LabAutoSig/Lab_Auto_Camera_Detection/Python_installation/requirements_display_detection.txt

numpy == 1.24.2
opencv-python == 4.6.0.66
opencv-contrib-python == 4.6.0.66
imutils == 0.5.4
uuid == 1.30
Ultralytics == 8.1.8
torch == 2.7.0
torchvision == 0.22.0
pandas == 2.0.1
dill == 0.3.8
openpyxl == 3.1.5
