LabAutoSig/Lab_Auto_Camera_Detection/display_detection/Enhanced_imgs/enhanced_img.png

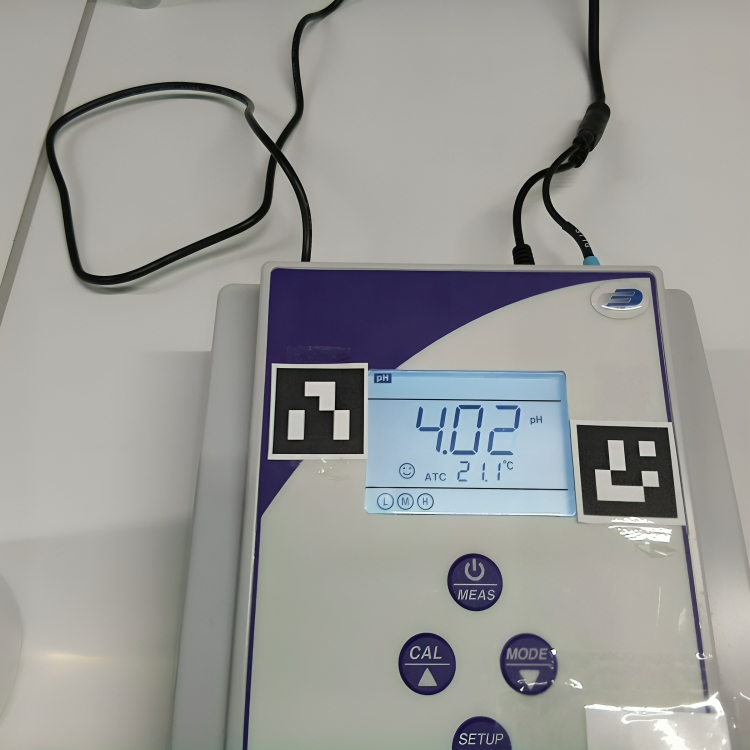
display_detection/Enhanced_imgs/enhanced_img.png
