LabAutoSig/Lab_Auto_Camera_Detection/display_detection/Processed_imgs/cropped_img.jpg

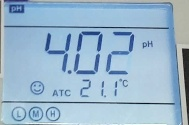
display_detection/Processed_imgs/cropped_img.jpg
