LabAutoSig/Lab_Auto_Camera_Detection/runs/detect/predict2/image0.jpg

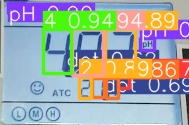
runs/detect/predict2/image0.jpg
