LabAutoSig/Lab_Auto_Camera_Detection/test.stp

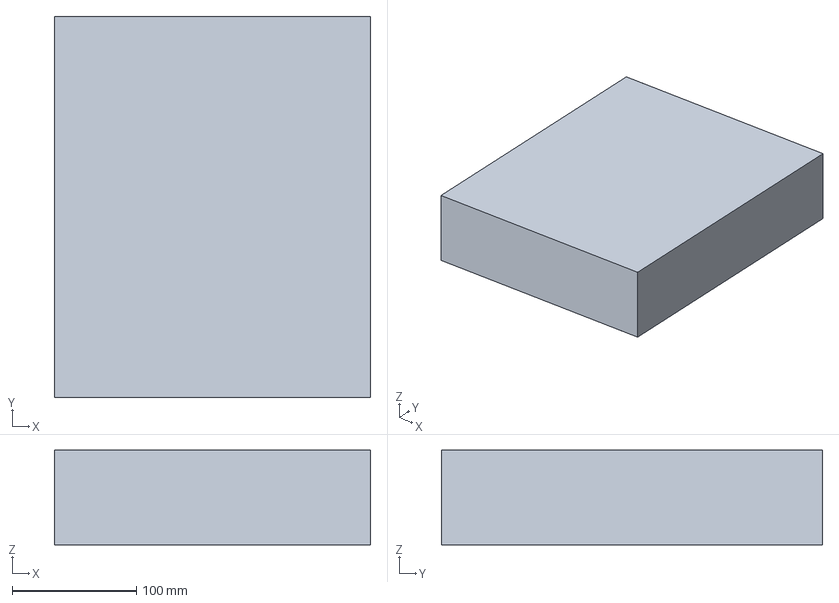
[picture p6: CAD file, 2025-05-23]
test.stp
254.1 x 306.6 x 76.3 mm
