LabAutoSig/Lab_Auto_Camera_Detection/three_D_reconstruction/HORST_world/test.stp

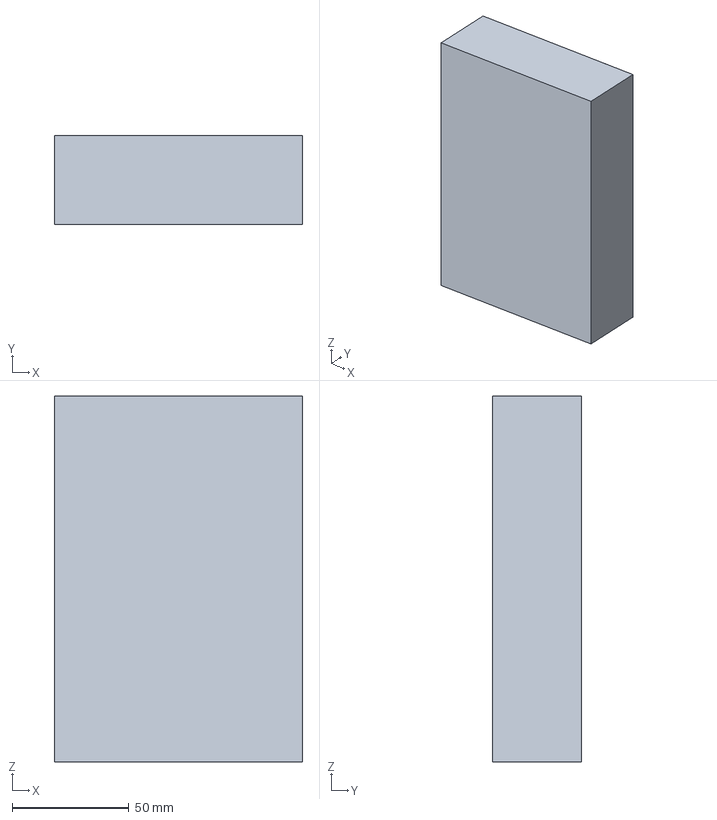
[picture p7: CAD file, 2025-04-29]
three_D_reconstruction/HORST_world/test.stp
106.3 x 38.1 x 156.6 mm
