LabAutoSig/Lab_Auto_Camera_Detection/Python_installation/requirements_3D_reconstruction.txt

numpy == 1.24.2
opencv-python == 4.6.0.66
opencv-contrib-python == 4.6.0.66
pandas == 2.0.1
scipy == 1.10.1
PySide2 == 5.15.2.1
wheel == 0.41.2
