LabAutoSig/Lab_Auto_Camera_Detection/three_D_reconstruction/input/coordinates_camera_pose1_camera_pose2.csv

Coordinates:
[  70.04308441 -448.60216797  203.53008667]
[-184.02915833 -142.02699554  184.3933374 ]
U
[[-61.08571121 -97.43288696 127.27883545]
 [-87.21105835 -92.19095886 122.80880371]
 [-83.19274399 -68.49335754 129.09041992]
 [-57.42921612 -73.02100647 130.8185083 ]]
Distances:
254.0722427368164
306.5751724243164
76.25125122070312
