LabAutoSig/Lab_Auto_Camera_Detection/autoit-v3/install/Examples/COM/Worksheet.xls

This is cell A1
 | This is cell B2
