LabAutoSig/Lab_Auto_Camera_Detection/autoit-v3/install/Examples/Helpfile/Extras/_Excel1.xls

Sheet: Tabelle1
1 | 10 | 100 | 1000 | 10000 | This is a long Story | Col1 | Col2 | Col3
2 | 20 | 200 | 2000 | 20000 | This is a Story that's even longer | f | 1 | 10.10 | 2012-10-01
3 | 30 | 300 | 3000 | 30000 |  | e | 2 | 9.70 | 2012-10-02
4 | 40 | 400 | 4000 | 40000 |  | d | 3 | 2.15 | 2012-10-03
5 | 50 | 500 | 5000 | 50000 |  | c | 4 | 3.00 | 2012-10-04
6 | 60 | 600 | 6000 | 60000 |  | b | 5 | 7.50 | 2012-10-05
7 | 70 | 700 | 7000 | 70000 |  | a | 6 | 26.08 | 2013-10-15
8 | 80 | 800 | 8000 | 80000 |  |  |  |  | 2013-10-16
9 | 90 | 900 | 9000 | 90000 |  |  |  |  | 2013-10-17
10 | 100 | 1000 | 10000 | 100000 |  |  |  |  | 2013-11-18
11 | 110 | 1100 | 11000 | 110000 |  |  |  |  | 2013-11-19
12 | 120 | 1200 | 12000 | 120000 |  |  |  |  | 2013-12-20
13 | 130 | 1300 | 13000 | 130000 |  |  |  |  | 2013-12-21
14 | 140 | 1400 | 14000 | 140000 |  |  |  |  | 2014-10-22
15 | 150 | 1500 | 15000 | 150000 |  |  |  |  | 2014-10-23
16 | 160 | 1600 | 16000 | 160000 |  |  |  |  | 2014-10-24
17 | 170 | 1700 | 17000 | 170000 |  |  |  |  | 2014-10-25
18 | 180 | 1800 | 18000 | 180000
19 | 190 | 1900 | 19000 | 190000
20 | 200 | 2000 | 20000 | 200000
21 | 210 | 2100 | 21000 | 210000
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
