LabAutoSig/Lab_Auto_Camera_Detection/autoit-v3/install/Examples/Helpfile/Extras/_Excel2.xls

Sheet: _ExcelWriteSheetFromArray
 |  |  | 20000
 |  |  | 30000
 |  |  | 40000
 |  |  | 50000
 |  |  | 60000
 |  |  | 70000
 |  |  | 80000
 |  |  | 90000
 | 20 | 200 | 100000
 | 30 | 300 | 110000
 | 40 | 400 | 120000
 | 50 | 500 | 130000
 | 60 | 600 | 140000
 | 70 | 700 | 150000
 | 80 | 800 | 160000
 | 90 | 900 | 170000
 | 100 | 1000 | 180000
 | 110 | 1100 | 190000
 | 120 | 1200 | 200000
 | 130 | 1300 | 210000
 | 140 | 1400 | 220000
 | 150 | 1500 | 230000
 | 160 | 1600 | 240000
 | 170 | 1700 | 250000
 | 180 | 1800 | 260000
 | 190 | 1900 | 270000
 | 200 | 2000 | 280000
 | 210 | 2100 | 290000
 | 220 | 2200 | 300000
 | 230 | 2300 | 310000
 | 240 | 2400 | 320000
 | 250 | 2500 | 330000
 | 260 | 2600 | 340000
 | 270 | 2700 | 350000
 | 280 | 2800 | 360000
 | 290 | 2900 | 370000
 | 300 | 3000 | 380000
 | 310 | 3100 | 390000
 | 320 | 3200 | 400000
 | 330 | 3300 | 410000
 | 340 | 3400 | 420000
 | 350 | 3500 | 430000
 | 360 | 3600 | 440000
 | 370 | 3700 | 450000
 | 380 | 3800 | 460000
 | 390 | 3900 | 470000
 | 400 | 4000 | 480000
 | 410 | 4100 | 490000
 | 420 | 4200 | 500000
 | 430 | 4300 | 510000
 | 440 | 4400 | 520000
 | 450 | 4500 | 530000
 | 460 | 4600 | 540000
 | 470 | 4700 | 550000
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
