LabAutoSig/Lab_Auto_Camera_Detection/autoit-v3/install/Examples/Helpfile/Extras/_Excel3.xls

Sheet: _ExcelWriteSheetFromArray
*-------------* | *-------------* | *-------------* | *-------------* | *-------------* | *-------------* | *-------------* | *-------------* | *-------------* | *-------------* | *-------------* | *-------------* | *-------------* | *-------------* | *-------------* | *-------------* | *-------------* | *-------------* | *-------------* | *-------------* | *-------------* | *-------------* | *-------------* | *-------------* | *-------------* | *-------------* | *-------------* | *-------------* | *-------------* | *-------------* | *-------------* | *-------------* | *-------------* | *-------------* | *-------------* | *-------------* | *-------------* | *-------------* | *-------------* | *-------------* | *-------------*
*-------------* | *-------------* | *-------------* | *-------------* | *-------------* | *-------------* | *-------------* | *-------------* | *-------------* | *-------------* | *-------------* | *-------------* | *-------------* | *-------------* | *-------------* | *-------------* | *-------------* | *-------------* | *-------------* | *-------------* | *-------------* | *-------------* | *-------------* | *-------------* | *-------------* | *-------------* | *-------------* | *-------------* | *-------------* | *-------------* | *-------------* | *-------------* | *-------------* | *-------------* | *-------------* | *-------------* | *-------------* | *-------------* | *-------------* | *-------------* | *-------------*
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

Sheet: Tabelle1
1 | 10 | 100 | 1000 | 10000
2 | 20 | 200 | 2000 | 20000
3 | 30 | 300 | 3000 | 30000
4 | 40 | 400 | 4000 | 40000
5 | 50 | 500 | 5000 | 50000
6 | 60 | 600 | 6000 | 60000
7 | 70 | 700 | 7000 | 70000
8 | 80 | 800 | 8000 | 80000
9 | 90 | 900 | 9000 | 90000
10 | 100 | 1000 | 10000 | 100000
11 | 110 | 1100 | 11000 | 110000
12 | 120 | 1200 | 12000 | 120000
13 | 130 | 1300 | 13000 | 130000
14 | 140 | 1400 | 14000 | 140000
15 | 150 | 1500 | 15000 | 150000
16 | 160 | 1600 | 16000 | 160000
17 | 170 | 1700 | 17000 | 170000
18 | 180 | 1800 | 18000 | 180000
19 | 190 | 1900 | 19000 | 190000
20 | 200 | 2000 | 20000 | 200000
21 | 210 | 2100 | 21000 | 210000
22 | 220 | 2200 | 22000 | 220000
23 | 230 | 2300 | 23000 | 230000
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
