LabAutoSig/Lab_Auto_Camera_Detection/autoit-v3/install/Examples/Helpfile/Extras/_Excel4.xls

Sheet: Tabelle1
Sheet1
A1 | B1 | C1 | D1
A2 | B2 | C2 | D2
A3 | B3 | C3 | D3
A4 | B4 | C4 | D4

Sheet: Tabelle2
Sheet2
A1 | B1 | C1 | D1
A2 | B2 | C2 | D2
A3 | B3 | C3 | D3
A4 | B4 | C4 | D4

Sheet: Tabelle3
Sheet3
A1 | B1 | C1 | D1
A2 | B2 | C2 | D2
A3 | B3 | C3 | D3
A4 | B4 | C4 | D4
