LabAutoSig/Lab_Auto_Camera_Detection/three_D_reconstruction/input/1.jpg

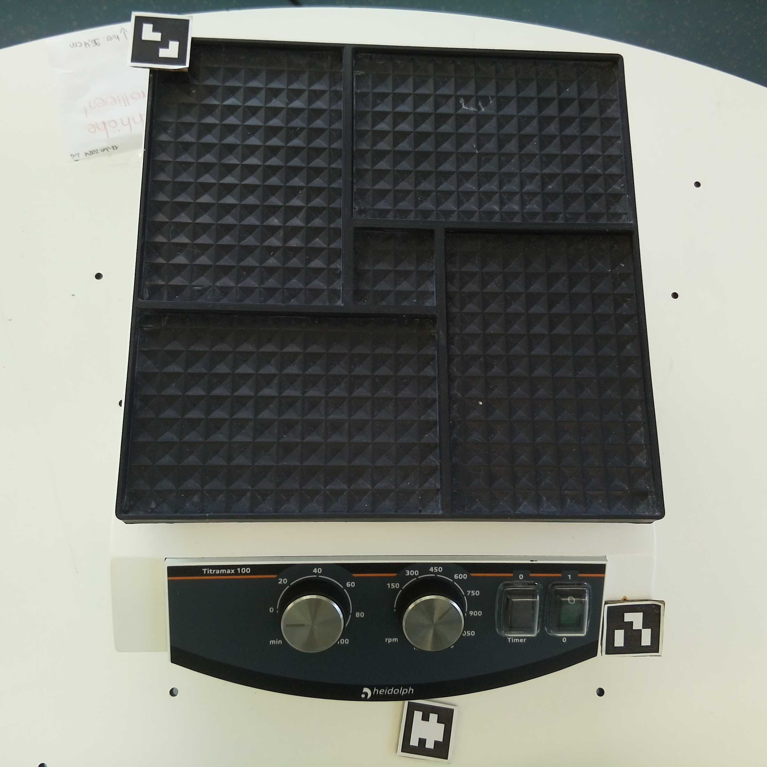
three_D_reconstruction/input/1.jpg
