LabAutoSig/Lab_Auto_Camera_Detection/three_D_reconstruction/input/07_05_devices/5.jpg

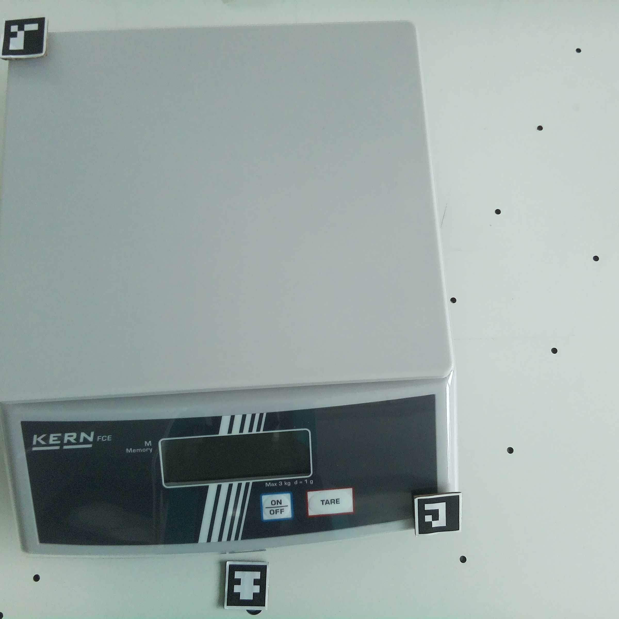
three_D_reconstruction/input/07_05_devices/5.jpg
