LabAutoSig/Lab_Auto_Camera_Detection/Python_installation/requirements_camera_calibration.txt

numpy == 1.26.2
opencv-contrib-python == 4.8.1.78
uuid == 1.30
