LabAutoSig/Lab_Auto_Camera_Detection/display_detection/Input_img/Test_imgs/Test_04_11_24/cs series scale/rawimg89.jpg

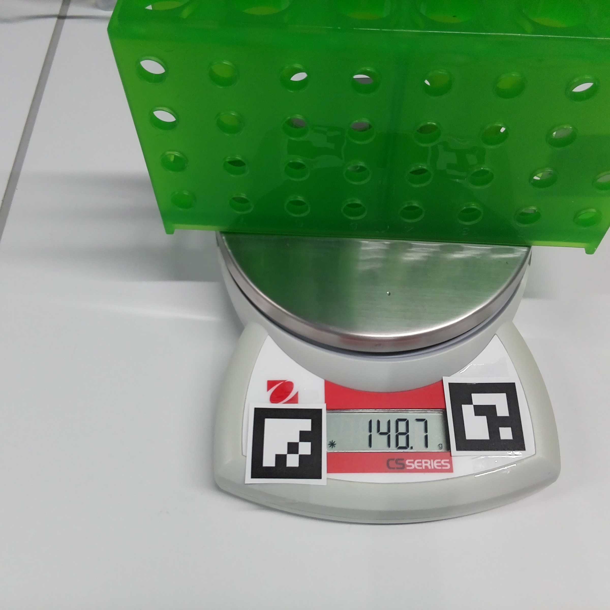
display_detection/Input_img/Test_imgs/Test_04_11_24/cs series scale/rawimg89.jpg
