LabAutoSig/Lab_Auto_Camera_Detection/display_detection/Input_img/Test_imgs/Variation_lighting/rawimg52.jpg

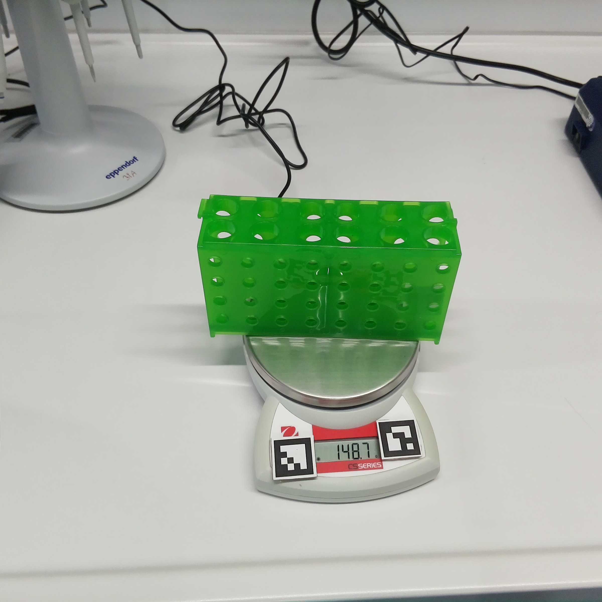
display_detection/Input_img/Test_imgs/Variation_lighting/rawimg52.jpg
