LabAutoSig/Lab_Auto_Camera_Detection/display_detection/Saved_Images/ result_6d22893f-a6d4-4648-952b-289575cfeb5b.jpg

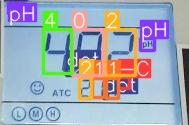
display_detection/Saved_Images/ result_6d22893f-a6d4-4648-952b-289575cfeb5b.jpg
