LabAutoSig/Lab_Auto_Camera_Detection/three_D_reconstruction/input/Control_Book_measurement/1.jpg

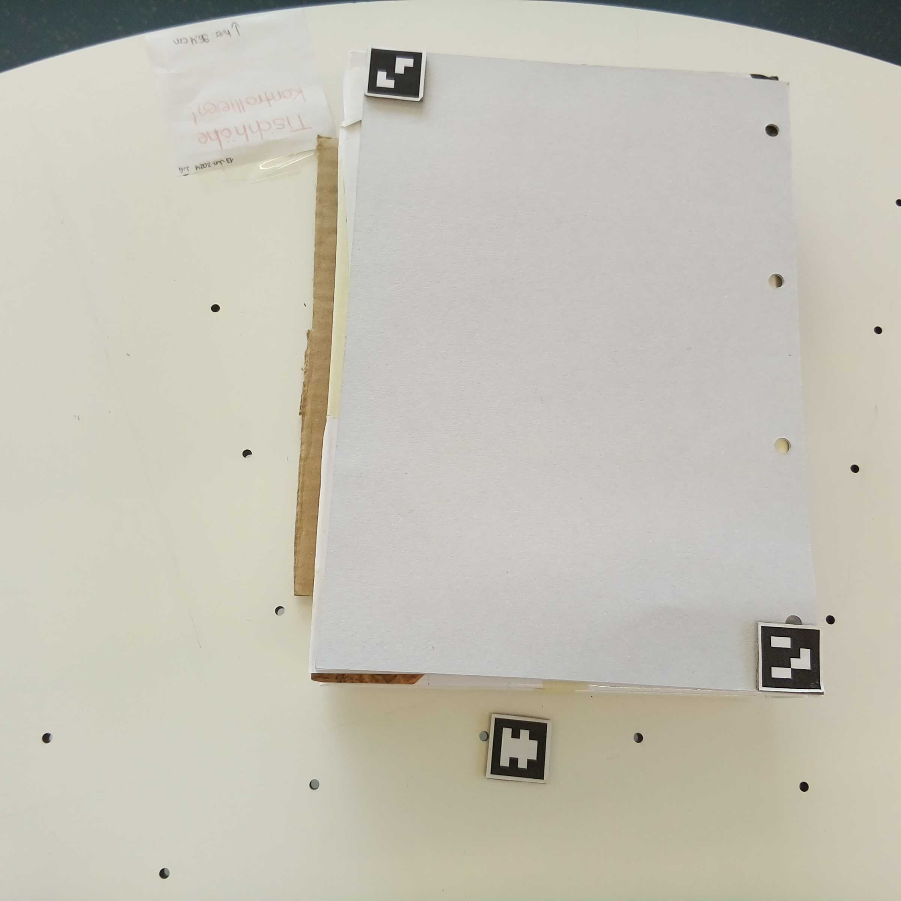
three_D_reconstruction/input/Control_Book_measurement/1.jpg
