LabAutoSig/Lab_Auto_Camera_Detection/three_D_reconstruction/input/test.jpg

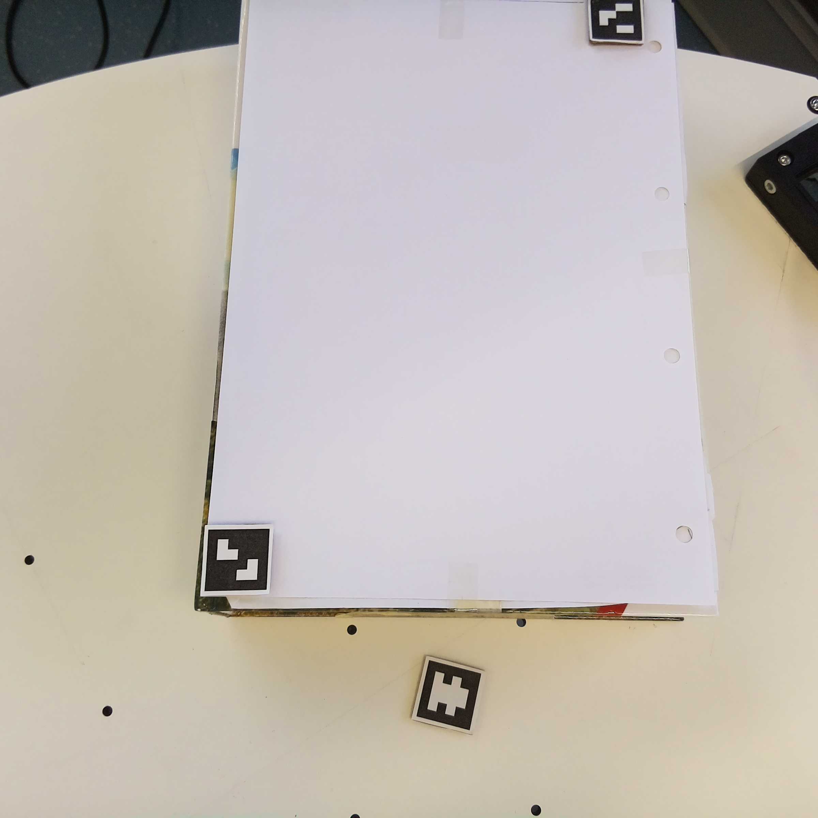
three_D_reconstruction/input/test.jpg
