LabAutoSig/Lab_Auto_Camera_Detection/(commit log)

2025-04-29 first upload
    [centrifuge_VWR_MicroStar12.xlsx, devices_config.csv, heating_and_magnetic_stirrer_RSM_10HP.xlsx, output.csv, pH_meter_ph50_DHS.xlsx, scales_CS_Series_CS200.xlsx, scales_KERN_FCE_3K1N.xlsx, test.stp]
2025-04-29 major advancements
    [XSInstruments_pH.xlsx, centrifuge_VWR_MicroStar12.xlsx, cs_series_scale.xlsx, devices_config.csv, heating_and_magnetic_stirrer_RSM_10HP.xlsx, heating_stirring_phoenix.xlsx, kern_scale.xlsx, output.csv]
2025-04-30 major 3d reconstruction enhancement
    [XSInstruments_pH.xlsx, output.csv, test.stp]
2025-05-02 calibration and reconstruction changes
    [Kamera_v2_Tool.step, coordinates_camera_pose27_camera_pose28.csv, test.stp]
2025-05-15 Publication Code update
    [Kamera_v2_Tool.step, centrifuge_VWR_MicroStar12.xlsx, coordinates_camera_pose11_camera_pose12.csv, coordinates_camera_pose1_camera_pose2.csv, coordinates_camera_pose27_camera_pose28.csv, coordinates_camera_pose3_camera_pose4.csv, coordinates_camera_pose5_camera_pose6.csv, coordinates_camera_pose7_camera_pose8.csv]
2025-05-22 Cleaned up display detection
    [Worksheet.xls, XSInstruments_pH.xlsx, _Excel1.xls, _Excel2.xls, _Excel3.xls, _Excel4.xls, centrifuge_VWR_MicroStar12.xlsx, coordinates_camera_pose1_camera_pose2.csv]
2025-05-22 GUI update
    [thermo_scientific_drybath.xlsx]
2025-05-22 torch upgrade
    [XSInstruments_pH.xlsx, output.csv]
2025-05-23 final version
    [XSInstruments_pH.xlsx, coordinates_camera_pose1_camera_pose2.csv, device_configs.csv, output.csv, test.stp]
